tymroche/KnockOut/STM32F103C8_breakout/STM32F103C8T6_Dev_Board_Doc.pdf

# STM32F103C8T6 Dev. Board

## Purpose

The purpose of this board is to be used as a development tool for the STM32f103C8T6 chip.

## Schematic Design

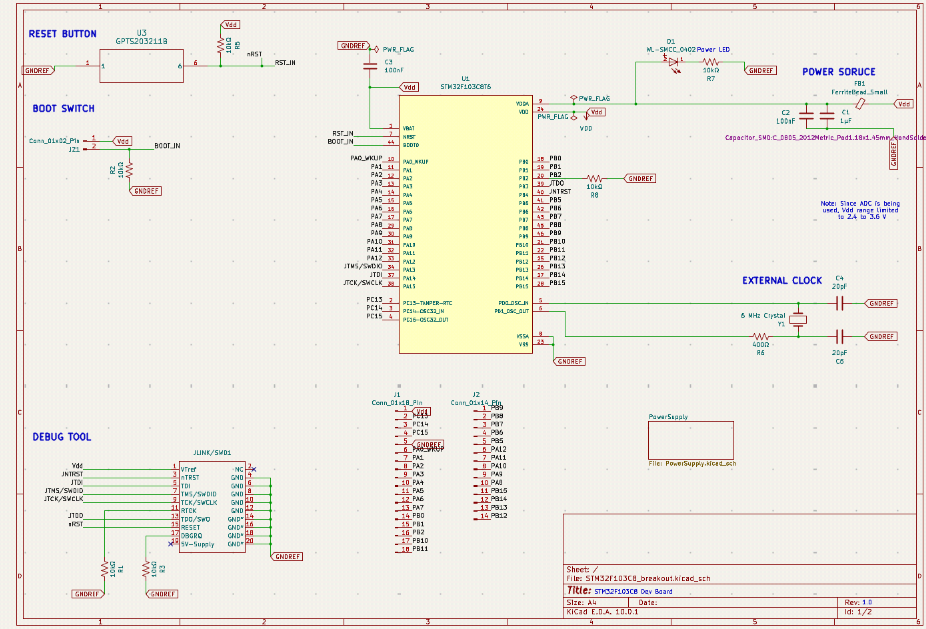
[picture p1: figure]

## PCB Design

Overview

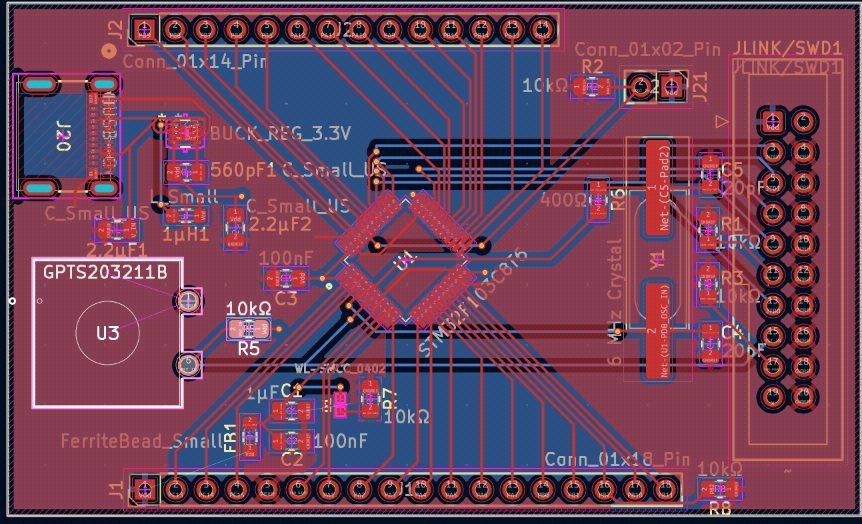
[picture p2: figure]
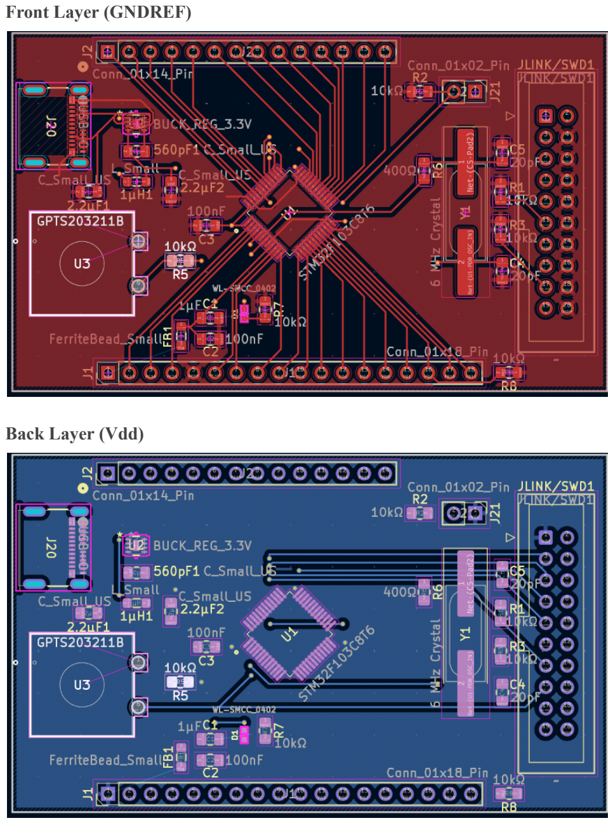
[picture p3: page 3]

Front Layer (GNDREF)

Back Layer (Vdd)

## Individual Components

### STM32F103C8T6 & Pin Headers

All GPIO pins that are not used internally (ex. JTAG/SWD Flash Pins) are broken out to male pin headers for general purpose use.

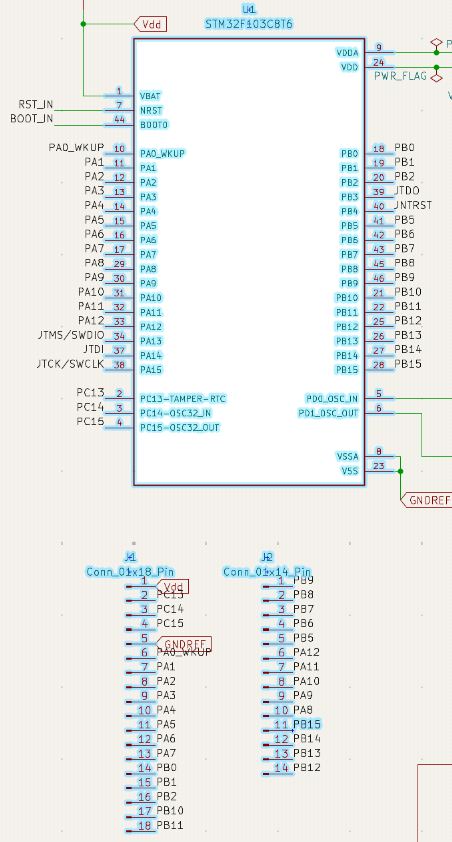
[picture p4: figure]
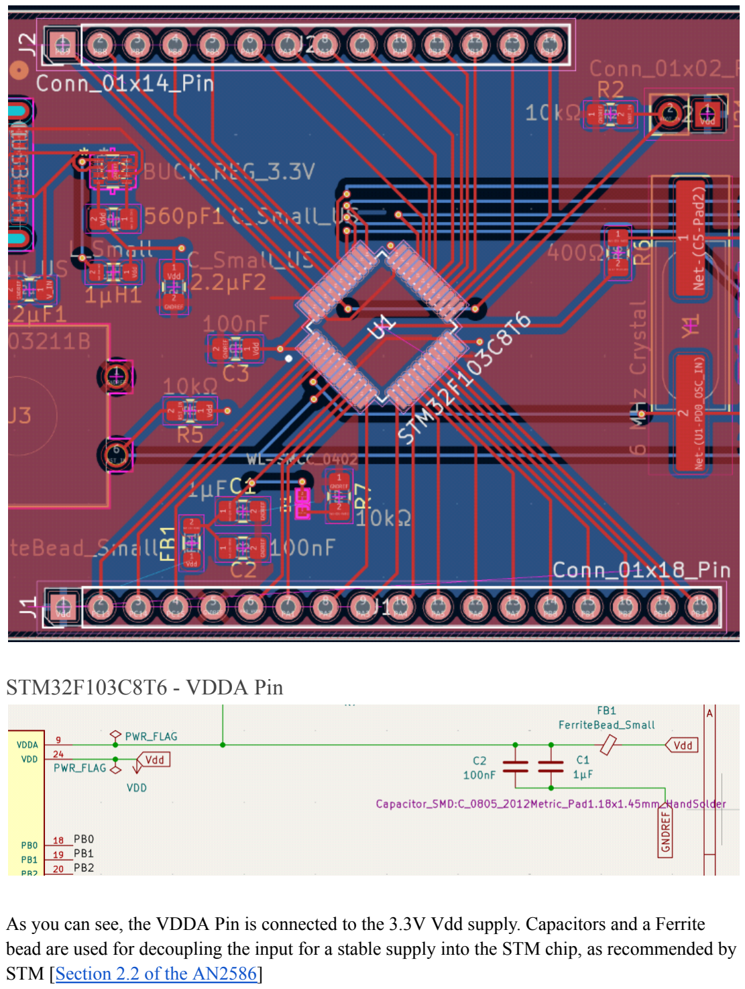
[picture p5: page 5]

STM32F103C8T6 - VDDA Pin

As you can see, the VDDA Pin is connected to the 3.3V Vdd supply. Capacitors and a Ferrite bead are used for decoupling the input for a stable supply into the STM chip, as recommended by STM [Section 2.2 of the AN2586] (https://www.st.com/resource/en/application_note/an2586-getting-started-with-stm32f10xxx-hardware-development-stmicroelectronics.pdf)

### Power Supply

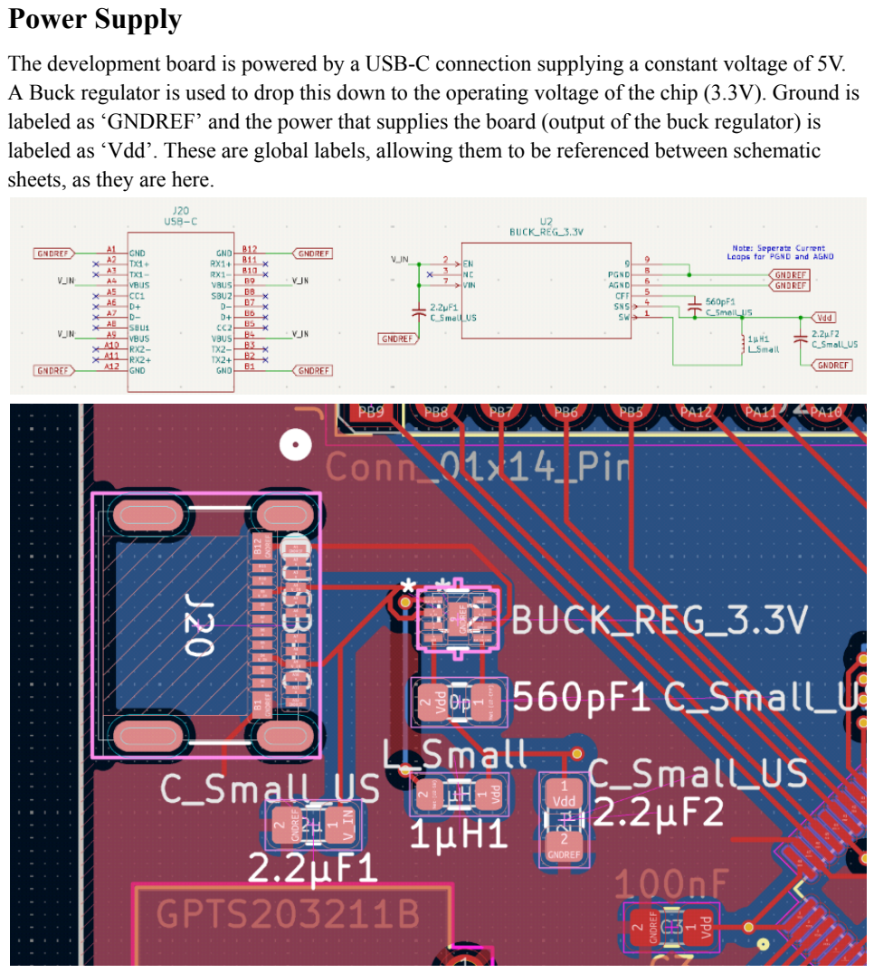
[picture p6: page 6]

The development board is powered by a USB-C connection supplying a constant voltage of 5V. A Buck regulator is used to drop this down to the operating voltage of the chip (3.3V). Ground is labeled as ‘GNDREF’ and the power that supplies the board (output of the buck regulator) is labeled as ‘Vdd’. These are global labels, allowing them to be referenced between schematic sheets, as they are here.

### Power LED

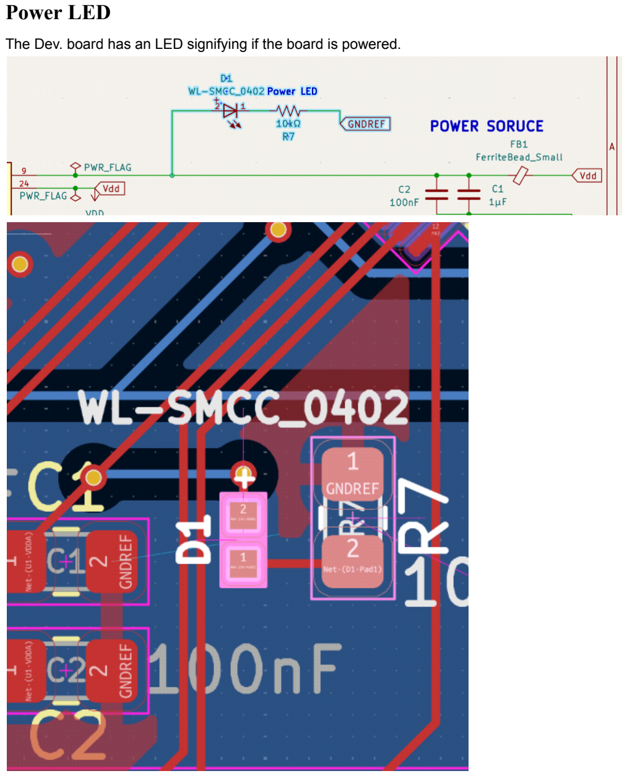
[picture p7: page 7]

The Dev. board has an LED signifying if the board is powered.

### Boot Switch

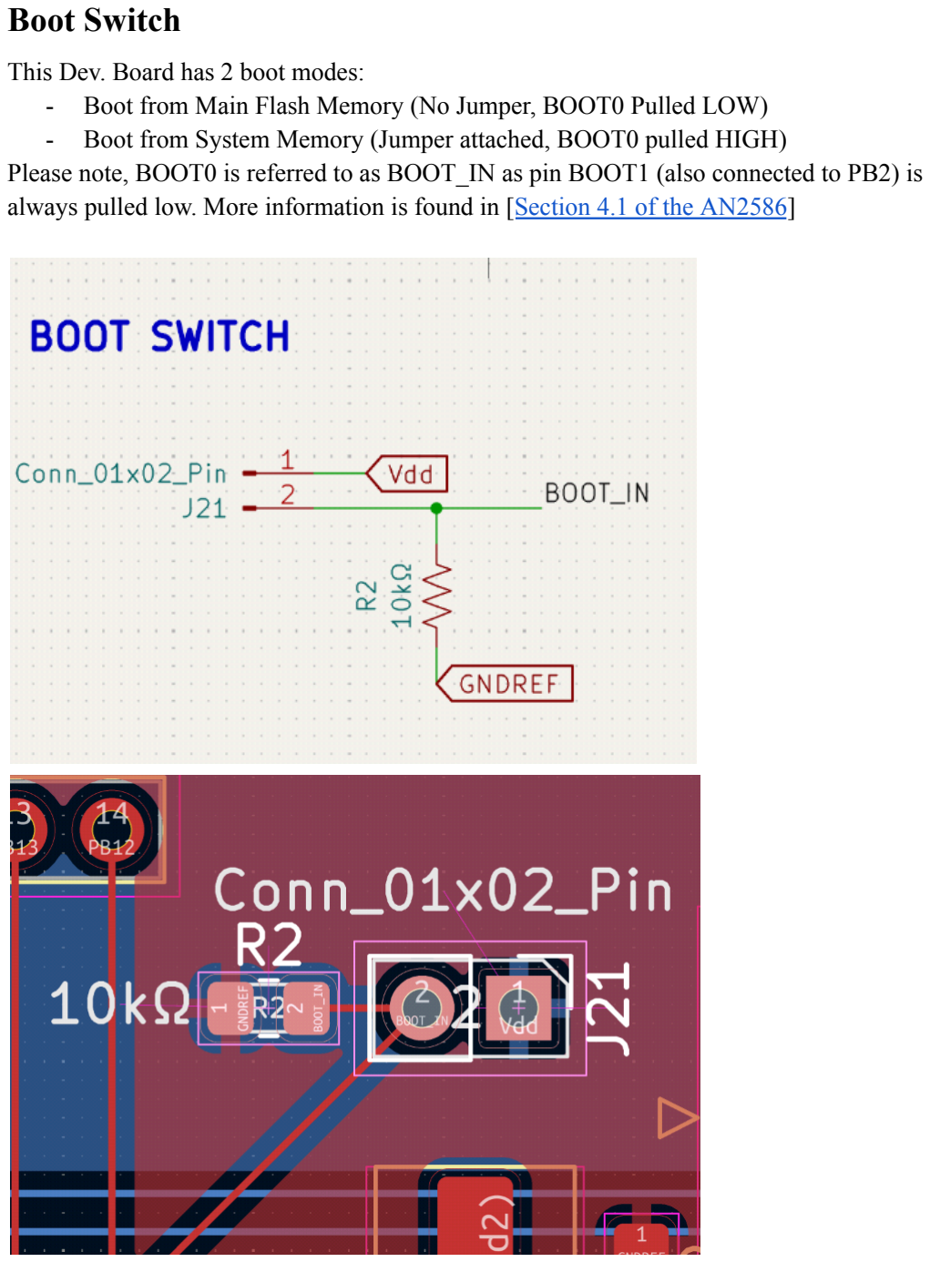
[picture p8: page 8]

This Dev. Board has 2 boot modes:
- Boot from Main Flash Memory (No Jumper, BOOT0 Pulled LOW)
- Boot from System Memory (Jumper attached, BOOT0 pulled HIGH)
Please note, BOOT0 is referred to as BOOT_IN as pin BOOT1 (also connected to PB2) is always pulled low. More information is found in [Section 4.1 of the AN2586] (https://www.st.com/resource/en/application_note/an2586-getting-started-with-stm32f10xxx-hardware-development-stmicroelectronics.pdf)

### Debug Tool

The Dev. Board can be flashed & debugged using a JTAG / SWD 20-pin J-LINK Header.

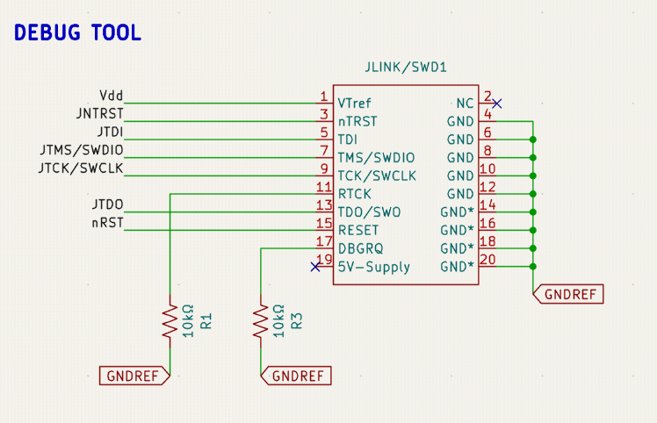
[picture p9: figure]
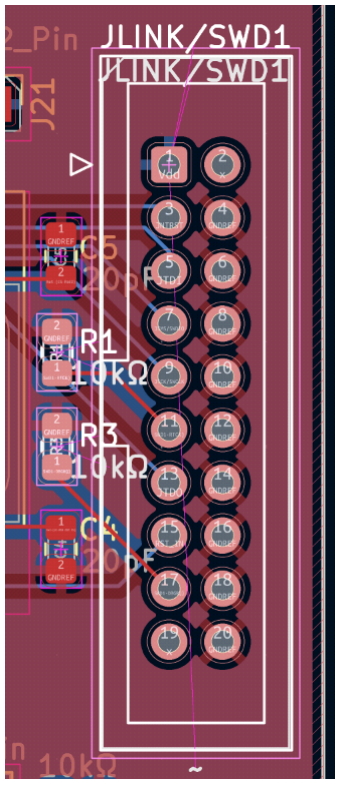
[picture p10: figure]

### External Clock

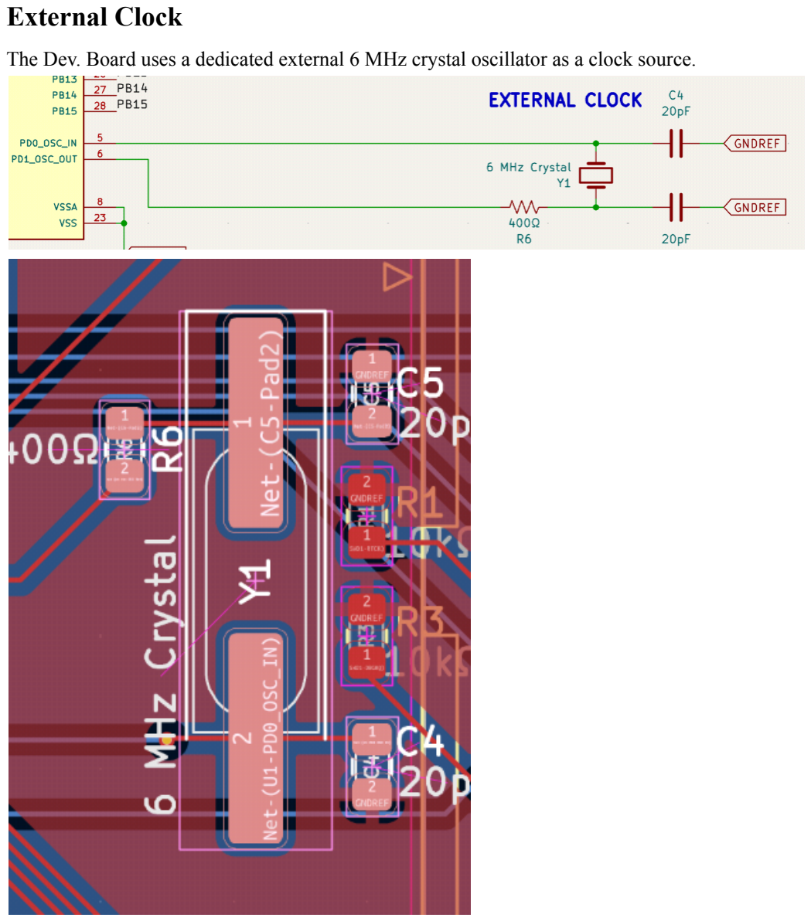
[picture p11: page 10]

The Dev. Board uses a dedicated external 6 MHz crystal oscillator as a clock source.

### Reset Button

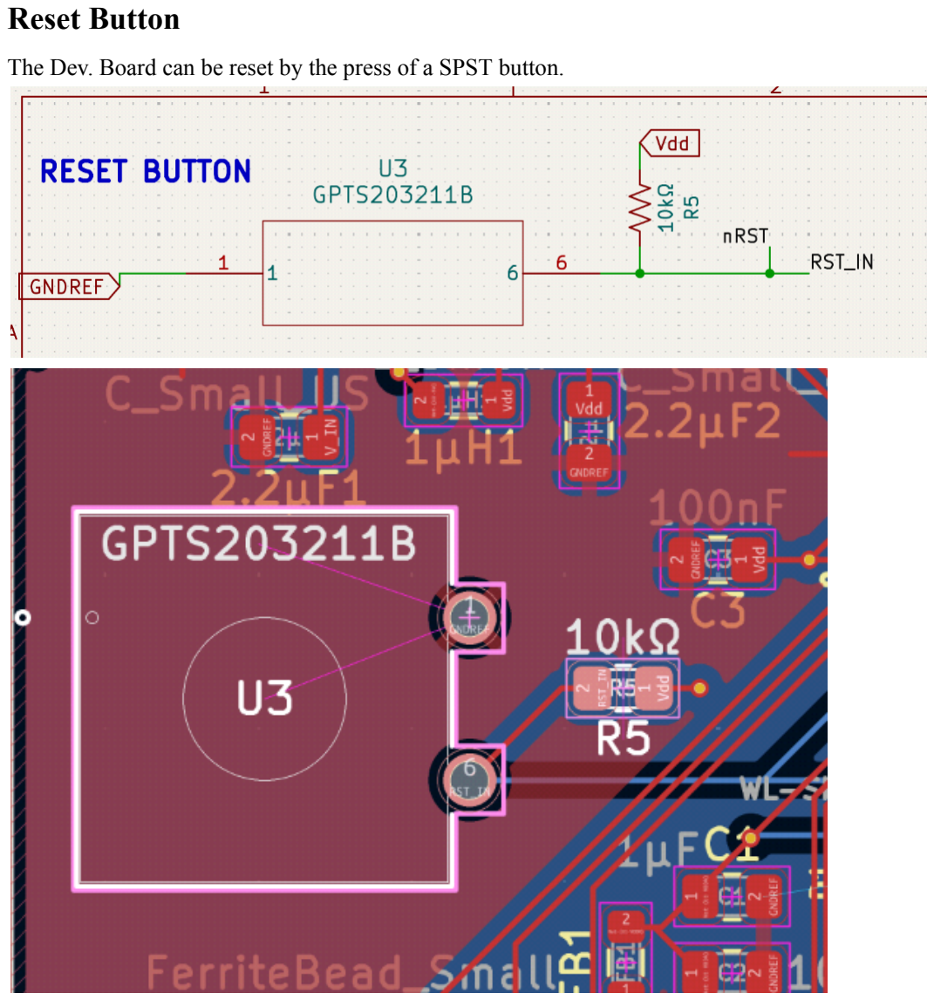
[picture p12: page 11]

The Dev. Board can be reset by the press of a SPST button.

## Bill of Materials

Part Name | Part Value (Quantity) | Cost | DigiKey Link | Datashet
Inductor | 1 µH (1) | n/a | n/a | n/a
Capacitor | 2.2 µF (2) 560 pF (1) 1 µF (1) 100 nF (2) 20 pF (2) | n/a | n/a | n/a
Resistor | 10 kΩ (6) 400 Ω (1) | n/a | n/a | n/a
Surface LED (Green) | (1) | $0.51 | https://www.digikey.com/en/products/detail/w%C3%BCrth-elektronik/150040GS73220/9857949 (https://www.digikey.com/en/products/detail/w%C3%BCrth-elektronik/150040GS73220/9857949) | https://www.we-online.com/components/products/datasheet/150040GS73220.pd f (https://www.we-online.com/components/products/datasheet/150040GS73220.pdf)
Ferrite Bead | (1) | n/a | n/a | n/a
Male Pin Headers | (34) | n/a | n/a | n/a
USB-C Female Header | (1) | $1.61 | https://www.digikey.com/en/products/detail/molex/1054500101/5843891 (https://www.digikey.com/en/products/detail/molex/1054500101/5843891) | https://tools.molex.com/pdm_docs/ps/PS -105448-001.pdf (https://tools.molex.com/pdm_docs/ps/PS-105448-001.pdf)
J-Link 20-Pin Male Box Header | (1) | n/a | n/a | n/a
STM32F103C8T6 (Dev. Chip) | (1) | n/a | n/a | n/a
3.3V Buck Regulator | (1) | $0.53 | https://www.digikey.com/en/products/detail/microchip-technology/MIC23050-SYML-TR/1980888 (https://www.digikey.com/en/products/detail/microchip-technology/MIC23050-SYML-TR/1980888) | https://ww1.microchip.com/downloads/en/DeviceDoc/mic23 050.pdf (https://ww1.microchip.com/downloads/en/DeviceDoc/mic23050.pdf)
SPST Button | (1) | $1.94 | https://www.digikey.com/en/products/detail/cw-industries/GPTS203211B/31905 90 (https://www.digikey.com/en/products/detail/cw-industries/GPTS203211B/3190590) | https://www.cwind.com/sites/cwind/files/gpts203211b.pdf (https://www.cwind.com/sites/cwind/files/gpts203211b.pdf)
6 MHz Crystal Oscillator | (1) | n/a | n/a | n/a

* (n/a) implies the components are already accessible for free.

## Resources

Github Repository: https://github.com/tymroche/KnockOut
- Schematic & PCB In folder STM32F103C8_breakout (https://github.com/tymroche/KnockOut/tree/main/STM32F103C8_breakout)
- Symbols & Footprints in Symbols_Footprints (https://github.com/tymroche/KnockOut/tree/main/Symbols_Footprints)
- Documents & Datasheets in Documentation (https://github.com/tymroche/KnockOut/tree/main/Documentation)
