tymroche/KnockOut/Documentation/Diagrams/KnockOutV1_StateMachineDiagram.png

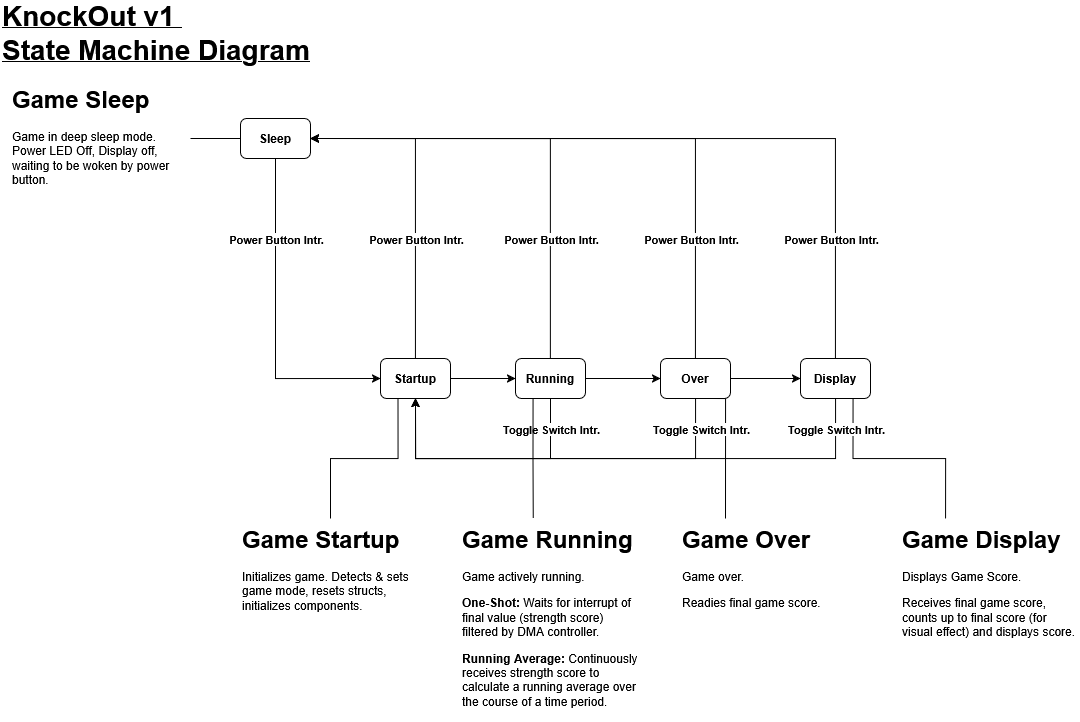
Documentation/Diagrams/KnockOutV1_StateMachineDiagram.png
