tymroche/KnockOut/Documentation/Pinouts/jtag_20pin_pinout.png

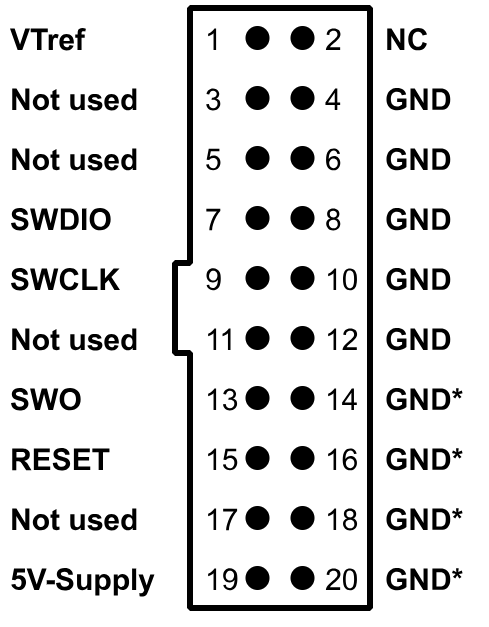
Documentation/Pinouts/jtag_20pin_pinout.png
