tymroche/KnockOut/Symbols_Footprints/150040GS73220/WL-SMCC_0402.step

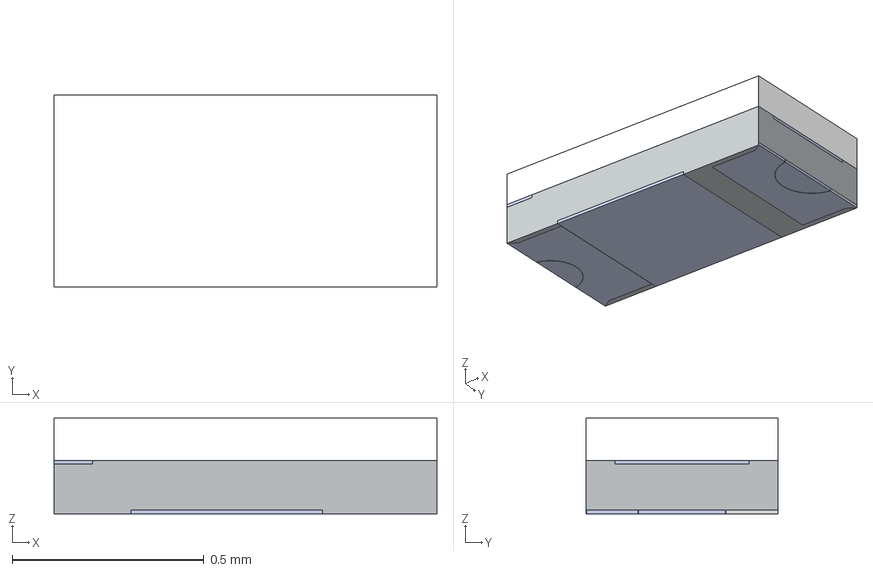
[picture p15: CAD file, 2026-06-06]
Symbols_Footprints/150040GS73220/WL-SMCC_0402.step
1.00 x 0.5 x 0.25 mm
PCB x 9
Resin
Contact x 8
