tymroche/KnockOut/STM32F103C8_breakout/STM32F103C8_breakout.kicad_pcb

## KiCad design STM32F103C8_breakout/STM32F103C8_breakout.kicad_pcb (2026-06-08)

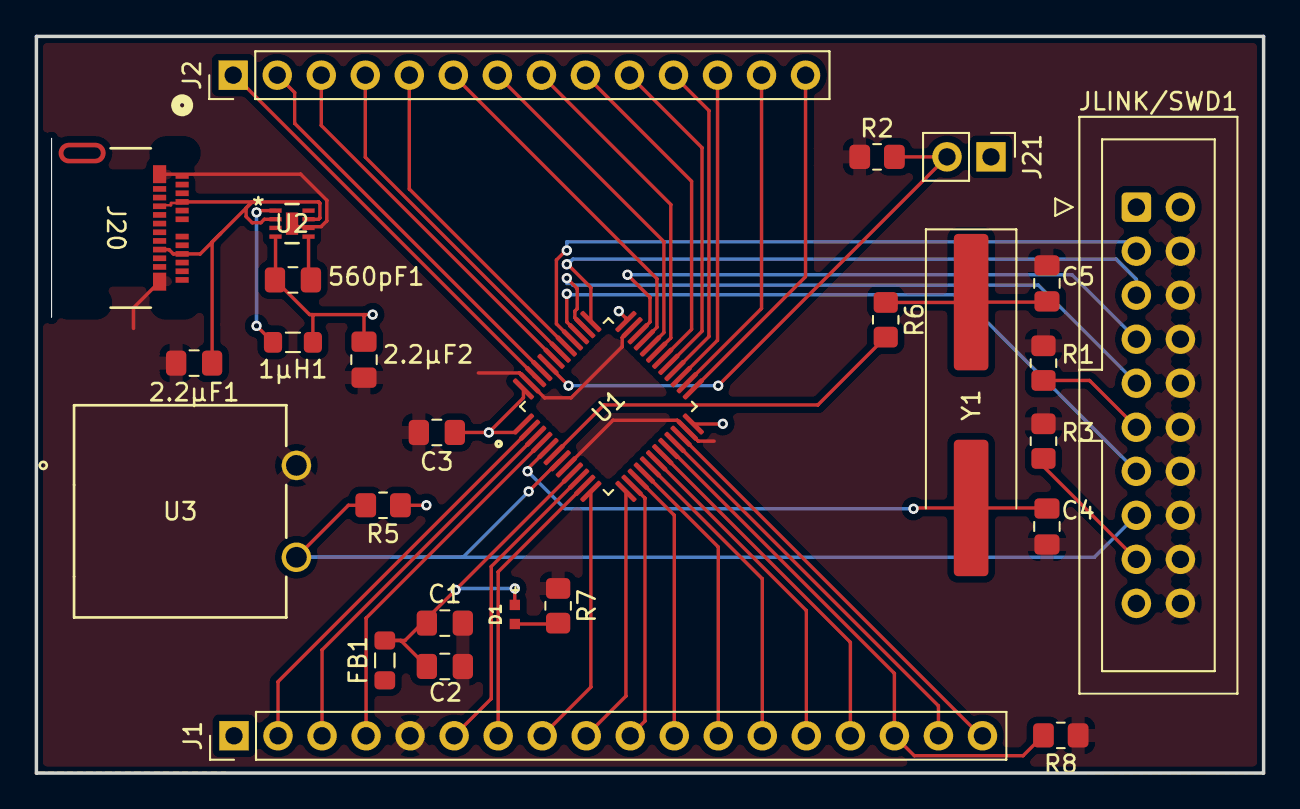
[picture p16: board STM32F103C8_breakout.kicad_pcb from above]

Board: 2 copper layers, 70.8 x 42.5 mm, 27 parts (0 on the bottom side), 49 nets.

Parts:
1µH1: L_Small; L_0805_2012Metric_Pad1.05x1.20mm_HandSolder
2.2µF1, 2.2µF2, 560pF1: C_Small_US; C_0805_2012Metric_Pad1.18x1.45mm_HandSolder
C1: 1μF; C_0805_2012Metric_Pad1.18x1.45mm_HandSolder
C2, C3: 100nF; C_0805_2012Metric_Pad1.18x1.45mm_HandSolder
C4, C5: 20pF; C_0805_2012Metric_Pad1.18x1.45mm_HandSolder
D1: WL-SMCC_0402
FB1: FerriteBead_Small; L_0805_2012Metric_Pad1.05x1.20mm_HandSolder
J1: Conn_01x18_Pin; PinHeader_1x18_P2.54mm_Vertical
J2: Conn_01x14_Pin; PinHeader_1x14_P2.54mm_Vertical
J20: USB-C; CONN_1054500101_MOL
J21: Conn_01x02_Pin; PinHeader_1x02_P2.54mm_Vertical
JLINK/SWD1: IDC-Header_2x10_P2.54mm_Vertical
R1, R2, R3, R5, R7, R8: 10kΩ; R_0805_2012Metric_Pad1.20x1.40mm_HandSolder
R6: 400Ω; R_0805_2012Metric_Pad1.20x1.40mm_HandSolder
U1: STM32F103C8T6; QFP50P900X900X160-48N
U2: BUCK_REG_3.3V; MLF-8_ML_MCH
U3: GPTS203211B; SWITCH_03211B
Y1: 6 MHz Crystal; Crystal_SMD_HC49-SD_HandSoldering

Connections:
/BOOT_IN: J21.2, R2.2, U1.44 (BOOT0)
/JNTRST: JLINK/SWD1.3 (nTRST), U1.40 (PB4)
/JTCK/SWCLK: JLINK/SWD1.9 (TCK/SWCLK), U1.38 (PA15)
/JTDI: JLINK/SWD1.5 (TDI), U1.37 (PA14)
/JTDO: JLINK/SWD1.13 (TDO/SWO), U1.39 (PB3)
/JTMS/SWDIO: JLINK/SWD1.7 (TMS/SWDIO), U1.34 (PA13)
/PA0_WKUP: J1.6, U1.10 (PA0_WKUP)
/PA1: J1.7, U1.11 (PA1)
/PA2: J1.8, U1.12 (PA2)
/PA3: J1.9, U1.13 (PA3)
/PA4: J1.10, U1.14 (PA4)
/PA5: J1.11, U1.15 (PA5)
/PA6: J1.12, U1.16 (PA6)
/PA7: J1.13, U1.17 (PA7)
/PA8: J2.10, U1.29 (PA8)
/PA9: J2.9, U1.30 (PA9)
/PA10: J2.8, U1.31 (PA10)
/PA11: J2.7, U1.32 (PA11)
/PA12: J2.6, U1.33 (PA12)
/PB0: J1.14, U1.18 (PB0)
/PB1: J1.15, U1.19 (PB1)
/PB2: J1.16, R8.2, U1.20 (PB2)
/PB5: J2.5, U1.41 (PB5)
/PB6: J2.4, U1.42 (PB6)
/PB7: J2.3, U1.43 (PB7)
/PB8: J2.2, U1.45 (PB8)
/PB9: J2.1, U1.46 (PB9)
/PB10: J1.17, U1.21 (PB10)
/PB11: J1.18, U1.22 (PB11)
/PB12: J2.14, U1.25 (PB12)
/PB13: J2.13, U1.26 (PB13)
/PB14: J2.12, U1.27 (PB14)
/PB15: J2.11, U1.28 (PB15)
/PC13: J1.2, U1.2 (PC13-TAMPER-RTC)
/PC14: J1.3, U1.3 (PC14-OSC32_IN)
/PC15: J1.4, U1.4 (PC15-OSC32_OUT)
/PowerSupply/V_IN: 2.2µF1.1, J20.A4 (VBUS), J20.A9 (VBUS), J20.B4 (VBUS), J20.B9 (VBUS), U2.2 (EN), U2.7 (VIN)
/RST_IN: JLINK/SWD1.15 (RESET), R5.2, U1.7 (NRST), U3.6
GNDREF: 2.2µF1.2, 2.2µF2.2, C1.2, C2.2, C3.2, C4.2, C5.1, J1.5, J20.A1 (GND), J20.A12 (GND), J20.B1 (GND), J20.B12 (GND), JLINK/SWD1.4 (GND), JLINK/SWD1.6 (GND), JLINK/SWD1.8 (GND), JLINK/SWD1.10 (GND), JLINK/SWD1.12 (GND), JLINK/SWD1.14 (GND*), JLINK/SWD1.16 (GND*), JLINK/SWD1.18 (GND*), JLINK/SWD1.20 (GND*), R1.2, R2.1, R3.2, R7.1, R8.1, U1.8 (VSSA), U1.23 (VSS), U1.35 (VSS), U1.47 (VSS), U2.6 (AGND), U2.8 (PGND), U2.9, U3.1
unnamed: C5.2, R6.1, Y1.1
unnamed: D1.1, R7.2
unnamed: JLINK/SWD1.17 (DBGRQ), R3.1
unnamed: JLINK/SWD1.11 (RTCK), R1.1
unnamed: C4.1, U1.5 (PD0_OSC_IN), Y1.2
unnamed: R6.2, U1.6 (PD1_OSC_OUT)
unnamed: C1.1, C2.1, D1.2, FB1.2, U1.9 (VDDA)
unnamed: 560pF1.1, U2.5 (CFF)
unnamed: 1µH1.2, U2.1 (SW)
Vdd: 1µH1.1, 2.2µF2.1, 560pF1.2, C3.1, FB1.1, J1.1, J21.1, JLINK/SWD1.1 (VTref), R5.1, U1.1 (VBAT), U1.24 (VDD), U1.36 (VDD), U1.48 (VDD), U2.4 (SNS)
