tymroche/KnockOut/(commit log)

2026-03-19 Initial Commit
    Files Created
    [KnockOutV1.kicad_pcb, KnockOutV1.kicad_sch]
2026-03-20 Added STM_Breakout and Documentation Files
    [KnockOutV1.kicad_pcb, KnockOutV1.kicad_sch]
2026-03-20 Began Schematic Pin Breakout
    [KnockOutV1.kicad_pcb, KnockOutV1.kicad_sch]
2026-03-20 PCB Pin Breakouts Finished
    [KnockOutV1.kicad_pcb]
2026-03-24 Rearraged Files
    [KnockOutV1.kicad_pcb, KnockOutV1.kicad_sch, STM32F103C8_breakout.kicad_pcb, STM32F103C8_breakout.kicad_sch]
2026-04-09 Refactored Dev. Board Schematic
    [STM32F103C8_breakout.kicad_sch]
2026-04-09 Updated schematic to (mostly) complete Dev Board.
    [STM32F103C8_breakout.kicad_sch]
2026-05-21 Added STM32 BluePill Test Code. Configured VSCode to program STM successfully.
2026-05-28 Added to Schematics
    [KnockOutV1.kicad_sch, PiezoOut.kicad_sch, STM32F103C8_breakout.kicad_pcb]
2026-05-29 Updated Boot Switch from SPDT to Jumper Functionality
    [PowerSupply.kicad_sch, STM32F103C8_breakout.kicad_pcb, STM32F103C8_breakout.kicad_sch]
2026-06-06 Worked on PCB Layout
    [PowerSupply.kicad_sch, STM32F103C8T6.step, STM32F103C8_breakout.kicad_pcb, STM32F103C8_breakout.kicad_sch, WL-SMCC_0402.step]
2026-06-06 Added any unsaved changes
    [STM32F103C8_breakout.kicad_pcb]
2026-06-07 Completed PCB Layoutx
    [PowerSupply.kicad_sch, STM32F103C8_breakout.kicad_pcb, STM32F103C8_breakout.kicad_sch]
2026-06-08 Finalized PCB Design. Ready for Review.
    [STM32F103C8_breakout.kicad_pcb, STM32F103C8_breakout.kicad_sch]
2026-06-17 Added decoupling capacitors for every Vdd net on STM chip.
2026-06-19 Connected Ferrite Bead + Fixed Cap. Values for Decoupling
    [STM32F103C8_breakout.kicad_pcb]
2026-06-23 Placed capacitor for battery input
    [STM32F103C8_breakout.kicad_sch]
2026-06-23 Filled Zones
    [STM32F103C8_breakout.kicad_pcb]
2026-06-27 Began schematic of KnockOutV1
    [KnockOutV1.kicad_sch]
